Lakshan-D/spacecraft-buck-converter/results/loop_load_step_zoom.png

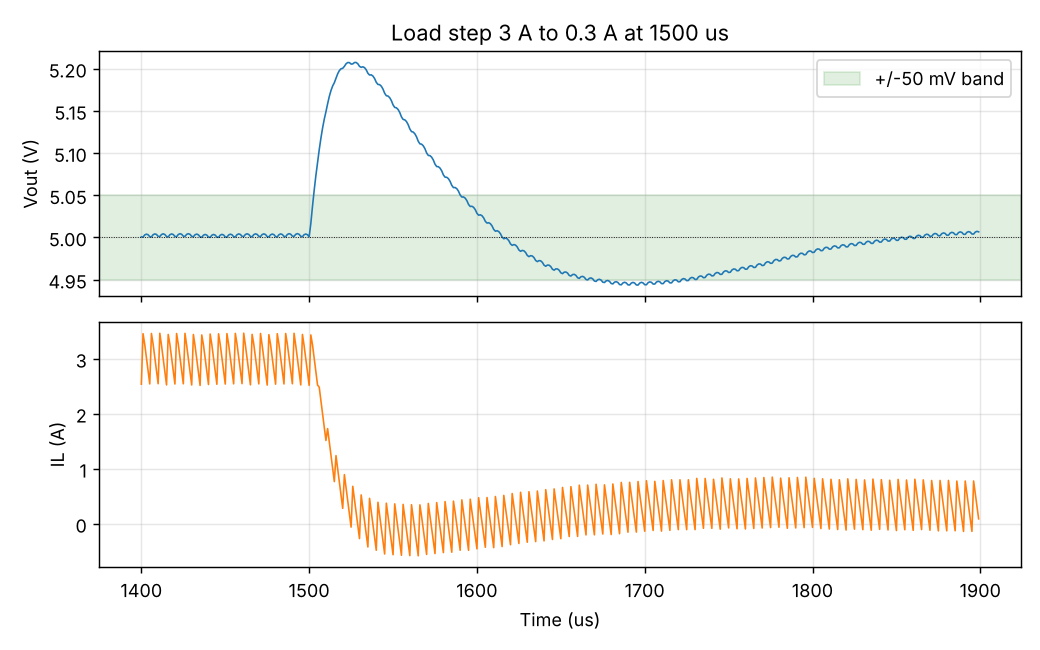
results/loop_load_step_zoom.png
