Lakshan-D/spacecraft-buck-converter/results/spice_load_step_open_loop.png

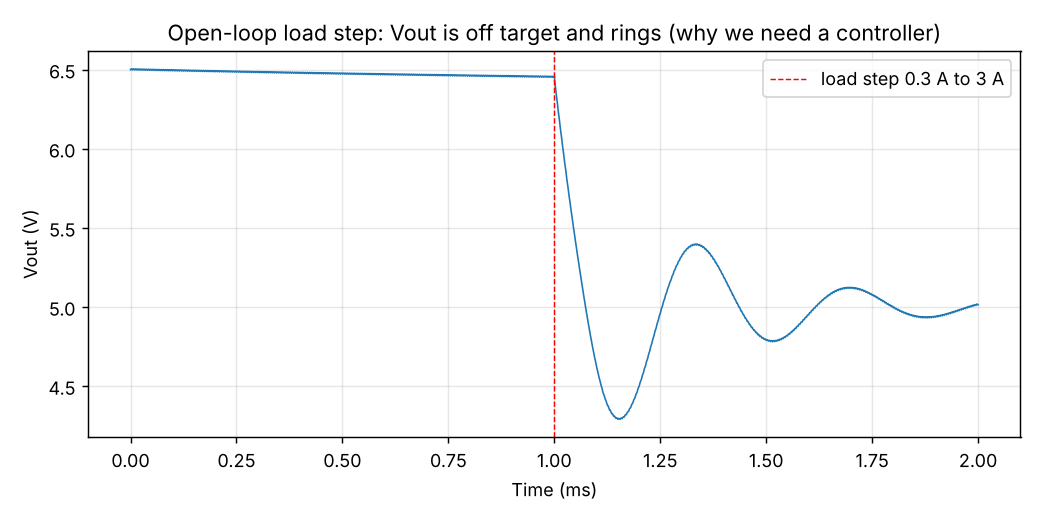
results/spice_load_step_open_loop.png
