Lakshan-D/spacecraft-buck-converter/results/ablation_summary.md

# Ablation: feedforward and soft start (auto-generated by scripts/ablation.py)

Peak deviation in mV / settling to +/-50 mV in us / peak inductor current in A.

| Event | Iteration 2 (neither) | Vin feedforward only | Soft start only | Feedforward + soft start |
|---|---|---|---|---|
| Start-up, 28 V, 3 A | 1079 / 552 / 10.3 | 1577 / 551 / 12.8 | 10 / 901 / 4.3 | 73 / 868 / 4.4 |
| Load 3 A to 0.3 A | 209 / 221 / 3.5 | 210 / 226 / 3.5 | 208 / 231 / 3.5 | 207 / 226 / 3.4 |
| Load 0.3 A to 3 A | 203 / 233 / 3.8 | 202 / 228 / 3.8 | 203 / 228 / 3.8 | 203 / 229 / 3.8 |
| Bus 28 V to 22 V | 232 / 226 / 3.5 | 30 / 0 / 3.3 | 234 / 226 / 3.5 | 31 / 0 / 3.3 |
| Bus 22 V to 36 V | 438 / 391 / 4.9 | 60 / 49 / 4.0 | 438 / 391 / 4.9 | 60 / 49 / 4.0 |
| Bus 36 V to 28 V | 193 / 215 / 3.6 | 24 / 0 / 3.5 | 194 / 216 / 3.6 | 23 / 0 / 3.5 |

## Bit-flip fault injection, same 200 upsets on both controllers

| Controller | Mode | Upsets > 100 mV | Upsets > 250 mV | Not recovered in 250 us | Worst peak (mV) | > 100 mV, clean starts only |
|---|---|---|---|---|---|---|
| Iteration 2 | no TMR | 57 / 200 | 43 / 200 | 35 / 200 | 2807 | 33 / 165 |
| Iteration 2 | TMR | 0 / 200 | 0 / 200 | 0 / 200 | 7 | 0 / 200 |
| Feedforward + soft start | no TMR | 69 / 200 | 54 / 200 | 44 / 200 | 5692 | 34 / 156 |
| Feedforward + soft start | TMR | 0 / 200 | 0 / 200 | 0 / 200 | 6 | 0 / 200 |
