Lakshan-D/spacecraft-buck-converter/results/loop_summary.md

# Closed-loop results (auto-generated by scripts/plot_results.py)

| Event | Peak deviation (mV) | Direction | Settling to +/-50 mV (us) | Peak IL (A) |
|---|---|---|---|---|
| Start-up, 28 V, 3 A | 73 | overshoot | 868 | 4.37 |
| Load 3 A to 0.3 A | 207 | overshoot | 226 | 3.43 |
| Load 0.3 A to 3 A | 203 | undershoot | 229 | 3.80 |
| Bus 28 V to 22 V | 31 | undershoot | 0 | 3.33 |
| Bus 22 V to 36 V | 60 | overshoot | 49 | 4.05 |
| Bus 36 V to 28 V | 23 | undershoot | 0 | 3.50 |

Steady state (28 V, 3 A): mean Vout = 5.0017 V, ripple = 7.1 mV pk-pk.
