Lakshan-D/spacecraft-buck-converter/results/spice_summary.md

# SPICE results (auto-generated by scripts/run_spice.py)

Nominal point (28 V in, 3 A out, typical parts): D = 0.19231, Vout = 5.000 V, ripple = 8.7 mV pk-pk, inductor ripple = 1.02 A pk-pk, efficiency = 91.8 %.

## Corner table (duty tuned per corner to hold 5.00 V)

| Vin (V) | Iout (A) | Parts | Duty | Vout (V) | Ripple (mV pk-pk) | IL pk (A) | Vsw max (V) | Eff (%) |
|---|---|---|---|---|---|---|---|---|
| 22 | 0.3 | cold | 0.19401 | 5.000 | 11.8 | 0.74 | 22.5 | 94.6 |
| 22 | 0.3 | typ | 0.19408 | 5.000 | 5.2 | 0.74 | 22.6 | 94.5 |
| 22 | 0.3 | hot | 0.19424 | 5.000 | 5.2 | 0.74 | 22.9 | 94.4 |
| 22 | 3.0 | cold | 0.24382 | 5.000 | 16.3 | 3.47 | 22.5 | 92.4 |
| 22 | 3.0 | typ | 0.24473 | 5.000 | 7.9 | 3.47 | 22.7 | 92.1 |
| 22 | 3.0 | hot | 0.24636 | 5.000 | 7.0 | 3.47 | 23.0 | 91.4 |
| 28 | 0.3 | cold | 0.14306 | 5.014 | 12.5 | 0.77 | 28.4 | 94.1 |
| 28 | 0.3 | typ | 0.14307 | 5.013 | 5.9 | 0.77 | 28.6 | 94.1 |
| 28 | 0.3 | hot | 0.14316 | 5.013 | 5.9 | 0.77 | 28.9 | 94.0 |
| 28 | 3.0 | cold | 0.19168 | 5.000 | 17.4 | 3.51 | 28.7 | 92.1 |
| 28 | 3.0 | typ | 0.19231 | 5.000 | 8.7 | 3.51 | 28.9 | 91.8 |
| 28 | 3.0 | hot | 0.19346 | 5.000 | 7.8 | 3.51 | 29.2 | 91.3 |
| 36 | 0.3 | cold | 0.10996 | 5.000 | 12.3 | 0.79 | 36.8 | 93.5 |
| 36 | 0.3 | typ | 0.11 | 5.000 | 5.6 | 0.79 | 37.1 | 93.5 |
| 36 | 0.3 | hot | 0.11008 | 5.000 | 5.7 | 0.79 | 37.6 | 93.4 |
| 36 | 3.0 | cold | 0.14898 | 5.000 | 18.1 | 3.53 | 36.7 | 91.9 |
| 36 | 3.0 | typ | 0.14942 | 5.000 | 9.3 | 3.53 | 37.0 | 91.6 |
| 36 | 3.0 | hot | 0.15022 | 5.000 | 8.4 | 3.53 | 37.5 | 91.1 |

## Open-loop line regulation (duty fixed at nominal)

| Vin (V) | Vout (V) |
|---|---|
| 22 | 3.870 |
| 28 | 5.000 |
| 36 | 6.509 |

Worst-case ripple 18.1 mV, worst-case inductor peak 3.53 A, worst-case switch node 37.6 V.

## Efficiency vs load (28 V in)

| Iout (A) | Eff (%) |
|---|---|
| 0.3 | 94.1 |
| 0.6 | 93.9 |
| 1.0 | 93.6 |
| 1.5 | 93.1 |
| 2.0 | 92.6 |
| 2.5 | 92.2 |
| 3.0 | 91.8 |
