Lakshan-D/spacecraft-buck-converter/results/fault_summary.md

# Fault injection results (auto-generated by scripts/plot_results.py)

Single bit flip in one state copy at a random time; Vout observed for 300 us.

| Metric | No TMR | TMR |
|---|---|---|
| Upsets injected | 200 | 200 |
| Upsets with peak error > 100 mV (2 %) | 69 | 0 |
| Upsets with peak error > 250 mV (5 %) | 54 | 0 |
| Not recovered to +/-50 mV within 250 us | 44 | 0 |
| Worst peak error (mV) | 5692 | 6 |
| Median peak error (mV) | 48 | 5 |

## Breakdown by register (no TMR)

| Register | Bits | Upsets | Caused > 100 mV |
|---|---|---|---|
| duty | 10 | 29 | 8 |
| e_prev | 16 | 46 | 12 |
| integrator | 32 | 91 | 37 |
| soft start ref | 12 | 34 | 12 |

With TMR, the voter output masks the flipped copy; the mismatch flag is raised in 200/200 cases (telemetry for ground).
