Lakshan-D/spacecraft-buck-converter/results/ablation_ff.csv

t_us | vo | il | duty | vin | rload
0.005 | 0.00000 | 0.00000 | x | 28.0 | 1.667
1.005 | 0.00000 | 0.00000 | 0 | 28.0 | 1.667
2.005 | 0.00000 | 0.00000 | 0 | 28.0 | 1.667
3.005 | 0.00000 | 0.00000 | 0 | 28.0 | 1.667
4.005 | 0.00000 | 0.00000 | 0 | 28.0 | 1.667
5.005 | 0.00000 | 0.00000 | 0 | 28.0 | 1.667
6.005 | 0.00354 | 1.15577 | 400 | 28.0 | 1.667
7.005 | 0.01547 | 2.42000 | 400 | 28.0 | 1.667
8.005 | 0.03574 | 3.67776 | 400 | 28.0 | 1.667
9.005 | 0.06428 | 4.92872 | 400 | 28.0 | 1.667
10.005 | 0.09746 | 5.01676 | 400 | 28.0 | 1.667
11.005 | 0.13390 | 6.14461 | 298 | 28.0 | 1.667
12.005 | 0.17841 | 7.37957 | 298 | 28.0 | 1.667
13.005 | 0.23092 | 8.60673 | 298 | 28.0 | 1.667
14.005 | 0.28767 | 8.64465 | 298 | 28.0 | 1.667
15.005 | 0.34386 | 8.59113 | 298 | 28.0 | 1.667
16.005 | 0.40301 | 9.69109 | 181 | 28.0 | 1.667
17.005 | 0.46989 | 10.77001 | 181 | 28.0 | 1.667
18.005 | 0.53943 | 10.69829 | 181 | 28.0 | 1.667
19.005 | 0.60821 | 10.62376 | 181 | 28.0 | 1.667
20.005 | 0.67621 | 10.54646 | 181 | 28.0 | 1.667
21.005 | 0.74696 | 11.62222 | 115 | 28.0 | 1.667
22.005 | 0.82281 | 11.83817 | 115 | 28.0 | 1.667
23.005 | 0.89798 | 11.74547 | 115 | 28.0 | 1.667
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
