Lakshan-D/spacecraft-buck-converter/results/ablation_ss.csv

t_us | vo | il | duty | vin | rload
0.005 | 0.00000 | 0.00000 | x | 28.0 | 1.667
1.005 | 0.00000 | 0.00000 | 0 | 28.0 | 1.667
2.005 | 0.00000 | 0.00000 | 0 | 28.0 | 1.667
3.005 | 0.00000 | 0.00000 | 0 | 28.0 | 1.667
4.005 | 0.00000 | 0.00000 | 0 | 28.0 | 1.667
5.005 | 0.00000 | 0.00000 | 0 | 28.0 | 1.667
6.005 | 0.00178 | 0.34240 | 27 | 28.0 | 1.667
7.005 | 0.00405 | 0.34072 | 27 | 28.0 | 1.667
8.005 | 0.00629 | 0.33894 | 27 | 28.0 | 1.667
9.005 | 0.00852 | 0.33707 | 27 | 28.0 | 1.667
10.005 | 0.01072 | 0.33510 | 27 | 28.0 | 1.667
11.005 | 0.01415 | 0.56127 | 18 | 28.0 | 1.667
12.005 | 0.01782 | 0.55800 | 18 | 28.0 | 1.667
13.005 | 0.02145 | 0.55458 | 18 | 28.0 | 1.667
14.005 | 0.02504 | 0.55101 | 18 | 28.0 | 1.667
15.005 | 0.02860 | 0.54730 | 18 | 28.0 | 1.667
16.005 | 0.03318 | 0.73361 | 15 | 28.0 | 1.667
17.005 | 0.03791 | 0.72867 | 15 | 28.0 | 1.667
18.005 | 0.04259 | 0.72354 | 15 | 28.0 | 1.667
19.005 | 0.04721 | 0.71822 | 15 | 28.0 | 1.667
20.005 | 0.05179 | 0.71272 | 15 | 28.0 | 1.667
21.005 | 0.05703 | 0.83380 | 10 | 28.0 | 1.667
22.005 | 0.06233 | 0.82732 | 10 | 28.0 | 1.667
23.005 | 0.06756 | 0.82062 | 10 | 28.0 | 1.667
24.005 | 0.07273 | 0.81372 | 10 | 28.0 | 1.667
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
