Lakshan-D/spacecraft-buck-converter/results/fault_base_tmr0.csv

idx | copy | bit | peak_mV | tail_mV | detected
0 | 0 | 53 | 2806.3 | 225.2 | 1
1 | 0 | 48 | 345.8 | 84.8 | 1
2 | 0 | 51 | 2807.0 | 266.7 | 1
3 | 0 | 7 | 291.7 | 34.2 | 1
4 | 0 | 62 | 38.3 | 7.1 | 1
5 | 0 | 43 | 21.5 | 4.7 | 1
6 | 0 | 65 | 8.4 | 4.6 | 1
7 | 0 | 45 | 76.2 | 8.4 | 1
8 | 0 | 0 | 12.5 | 2.6 | 1
9 | 0 | 40 | 6.6 | 4.4 | 1
10 | 0 | 47 | 294.4 | 29.3 | 1
11 | 0 | 68 | 37.8 | 7.5 | 1
12 | 0 | 25 | 78.0 | 23.3 | 1
13 | 0 | 60 | 10.8 | 4.4 | 1
14 | 0 | 69 | 4.6 | 2.6 | 1
15 | 0 | 33 | 6.5 | 4.6 | 1
16 | 0 | 58 | 4.5 | 2.9 | 1
17 | 0 | 2 | 5.0 | 4.5 | 1
18 | 0 | 20 | 85.2 | 22.9 | 1
19 | 0 | 54 | 2806.0 | 257.7 | 1
20 | 0 | 66 | 348.1 | 46.6 | 1
21 | 0 | 63 | 46.0 | 5.6 | 1
22 | 0 | 37 | 4.5 | 2.5 | 1
23 | 0 | 48 | 585.5 | 50.8 | 1
24 | 0 | 10 | 77.2 | 11.0 | 1
25 | 0 | 41 | 10.6 | 4.3 | 1
26 | 0 | 19 | 83.5 | 23.2 | 1
27 | 0 | 6 | 10.7 | 4.6 | 1
28 | 0 | 36 | 4.7 | 4.4 | 1
29 | 0 | 69 | 4.6 | 3.7 | 1
30 | 0 | 7 | 106.4 | 24.4 | 1
31 | 0 | 56 | 2805.2 | 232.3 | 1
32 | 0 | 25 | 280.0 | 37.3 | 1
33 | 0 | 17 | 206.8 | 47.1 | 1
34 | 0 | 67 | 18.0 | 6.3 | 1
35 | 0 | 24 | 265.9 | 67.6 | 1
36 | 0 | 8 | 29.2 | 6.4 | 1
37 | 0 | 6 | 5.6 | 4.5 | 1
38 | 0 | 20 | 85.2 | 23.6 | 1
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
