Lakshan-D/spacecraft-buck-converter/results/fault_base_tmr1.csv

idx | copy | bit | peak_mV | tail_mV | detected
0 | 1 | 53 | 4.5 | 4.5 | 1
1 | 1 | 3 | 4.9 | 4.4 | 1
2 | 1 | 7 | 4.9 | 4.6 | 1
3 | 0 | 60 | 4.7 | 3.5 | 1
4 | 1 | 65 | 4.6 | 2.8 | 1
5 | 2 | 64 | 4.8 | 4.0 | 1
6 | 1 | 40 | 4.7 | 4.4 | 1
7 | 1 | 58 | 5.1 | 2.7 | 1
8 | 2 | 25 | 6.7 | 6.7 | 1
9 | 1 | 17 | 6.2 | 2.8 | 1
10 | 2 | 33 | 5.1 | 4.4 | 1
11 | 1 | 47 | 4.5 | 2.6 | 1
12 | 2 | 20 | 6.7 | 4.6 | 1
13 | 2 | 56 | 5.0 | 2.8 | 1
14 | 1 | 63 | 5.1 | 2.5 | 1
15 | 2 | 63 | 6.7 | 6.2 | 1
16 | 0 | 10 | 5.0 | 4.4 | 1
17 | 1 | 50 | 5.1 | 3.4 | 1
18 | 0 | 6 | 6.0 | 6.0 | 1
19 | 2 | 14 | 6.7 | 3.8 | 1
20 | 1 | 7 | 5.1 | 4.4 | 1
21 | 2 | 60 | 4.5 | 2.6 | 1
22 | 2 | 17 | 6.7 | 4.6 | 1
23 | 2 | 42 | 5.0 | 2.8 | 1
24 | 0 | 8 | 5.1 | 2.6 | 1
25 | 2 | 21 | 6.7 | 6.2 | 1
26 | 1 | 65 | 5.0 | 4.8 | 1
27 | 1 | 35 | 5.1 | 4.0 | 1
28 | 0 | 42 | 5.2 | 5.2 | 1
29 | 0 | 2 | 6.7 | 4.3 | 1
30 | 2 | 20 | 5.1 | 5.1 | 1
31 | 1 | 47 | 4.5 | 2.6 | 1
32 | 2 | 16 | 6.7 | 4.6 | 1
33 | 1 | 32 | 5.0 | 3.9 | 1
34 | 0 | 68 | 5.1 | 2.6 | 1
35 | 2 | 26 | 6.7 | 6.2 | 1
36 | 0 | 26 | 5.0 | 5.0 | 1
37 | 0 | 68 | 5.1 | 4.5 | 1
38 | 1 | 30 | 4.4 | 4.4 | 1
39 | 2 | 37 | 6.7 | 4.3 | 1
40 | 2 | 17 | 5.1 | 5.1 | 1
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
