Lakshan-D/spacecraft-buck-converter/results/fault_tmr0.csv

idx | copy | bit | peak_mV | tail_mV | detected
0 | 0 | 53 | 5576.1 | 301.2 | 1
1 | 0 | 48 | 904.0 | 90.3 | 1
2 | 0 | 51 | 5541.0 | 328.6 | 1
3 | 0 | 7 | 318.7 | 37.6 | 1
4 | 0 | 62 | 43.8 | 6.5 | 1
5 | 0 | 43 | 19.6 | 3.4 | 1
6 | 0 | 65 | 8.6 | 4.6 | 1
7 | 0 | 45 | 75.7 | 9.4 | 1
8 | 0 | 0 | 10.6 | 4.4 | 1
9 | 0 | 40 | 4.6 | 4.6 | 1
10 | 0 | 47 | 296.7 | 27.7 | 1
11 | 0 | 68 | 38.6 | 6.9 | 1
12 | 0 | 25 | 79.8 | 22.8 | 1
13 | 0 | 60 | 9.3 | 2.4 | 1
14 | 0 | 69 | 4507.1 | 3343.4 | 1
15 | 0 | 33 | 2391.3 | 482.5 | 1
16 | 0 | 58 | 180.8 | 13.5 | 1
17 | 0 | 2 | 8.7 | 6.5 | 1
18 | 0 | 20 | 264.0 | 67.6 | 1
19 | 0 | 54 | 5589.9 | 338.7 | 1
20 | 0 | 66 | 366.9 | 48.1 | 1
21 | 0 | 63 | 47.7 | 6.6 | 1
22 | 0 | 37 | 4.7 | 4.4 | 1
23 | 0 | 48 | 588.4 | 55.4 | 1
24 | 0 | 10 | 72.5 | 10.5 | 1
25 | 0 | 41 | 10.6 | 4.3 | 1
26 | 0 | 19 | 87.0 | 25.4 | 1
27 | 0 | 6 | 11.8 | 4.4 | 1
28 | 0 | 36 | 6.9 | 4.8 | 1
29 | 0 | 69 | 4508.6 | 3298.3 | 1
30 | 0 | 7 | 2326.4 | 478.3 | 1
31 | 0 | 56 | 5692.3 | 287.8 | 1
32 | 0 | 25 | 281.5 | 40.1 | 1
33 | 0 | 17 | 208.7 | 46.6 | 1
34 | 0 | 67 | 507.0 | 121.4 | 1
35 | 0 | 24 | 107.1 | 30.7 | 1
36 | 0 | 8 | 10.6 | 4.6 | 1
37 | 0 | 6 | 4.8 | 4.4 | 1
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
