Lakshan-D/spacecraft-buck-converter/results/fault_tmr1.csv

idx | copy | bit | peak_mV | tail_mV | detected
0 | 1 | 53 | 4.9 | 4.4 | 1
1 | 1 | 3 | 4.7 | 4.7 | 1
2 | 1 | 7 | 5.1 | 4.6 | 1
3 | 0 | 60 | 4.8 | 4.4 | 1
4 | 1 | 65 | 2.6 | 2.6 | 1
5 | 2 | 64 | 6.5 | 4.5 | 1
6 | 1 | 40 | 5.0 | 4.4 | 1
7 | 1 | 58 | 4.9 | 4.3 | 1
8 | 2 | 25 | 4.7 | 4.6 | 1
9 | 1 | 17 | 4.8 | 4.6 | 1
10 | 2 | 33 | 5.0 | 2.6 | 1
11 | 1 | 47 | 5.1 | 5.0 | 1
12 | 2 | 20 | 4.8 | 4.8 | 1
13 | 2 | 56 | 4.5 | 2.5 | 1
14 | 1 | 63 | 6.5 | 6.5 | 1
15 | 2 | 63 | 6.5 | 5.0 | 1
16 | 0 | 10 | 4.5 | 4.5 | 1
17 | 1 | 50 | 4.9 | 4.7 | 1
18 | 0 | 6 | 4.8 | 4.8 | 1
19 | 2 | 14 | 4.6 | 4.6 | 1
20 | 1 | 7 | 5.1 | 4.5 | 1
21 | 2 | 60 | 5.0 | 4.4 | 1
22 | 2 | 17 | 4.8 | 4.5 | 1
23 | 2 | 42 | 4.5 | 2.5 | 1
24 | 0 | 8 | 6.5 | 4.5 | 1
25 | 2 | 21 | 5.0 | 3.6 | 1
26 | 1 | 65 | 4.9 | 4.5 | 1
27 | 1 | 35 | 4.7 | 4.4 | 1
28 | 0 | 42 | 4.8 | 4.4 | 1
29 | 0 | 2 | 5.0 | 4.1 | 1
30 | 2 | 20 | 5.1 | 3.2 | 1
31 | 1 | 47 | 5.0 | 4.8 | 1
32 | 2 | 16 | 4.7 | 2.3 | 1
33 | 1 | 32 | 6.5 | 6.5 | 1
34 | 0 | 68 | 6.5 | 3.2 | 1
35 | 2 | 26 | 5.0 | 4.4 | 1
36 | 0 | 26 | 4.9 | 3.6 | 1
37 | 0 | 68 | 4.7 | 3.9 | 1
38 | 1 | 30 | 4.8 | 4.2 | 1
39 | 2 | 37 | 5.1 | 5.1 | 1
40 | 2 | 17 | 5.0 | 4.4 | 1
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
