Lakshan-D/spacecraft-buck-converter/results/spice_efficiency.png

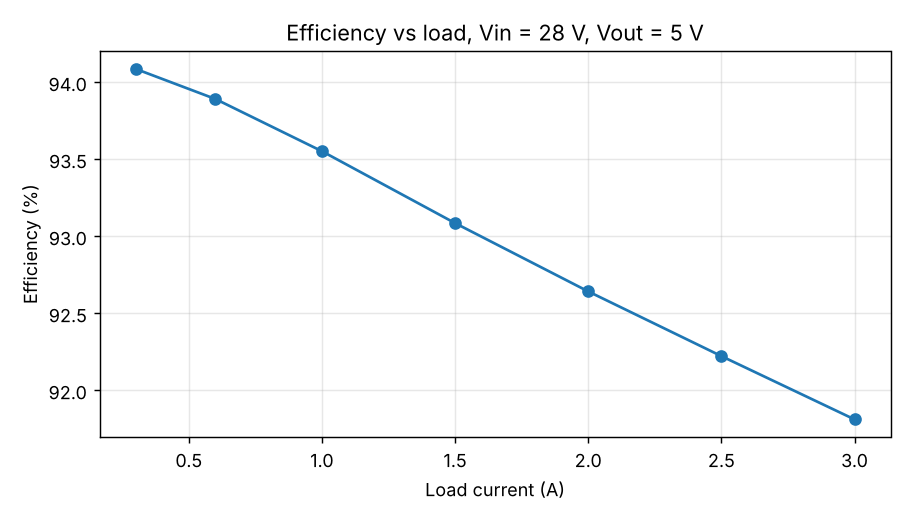
results/spice_efficiency.png
