Lakshan-D/spacecraft-buck-converter/results/spice_steady_state.png

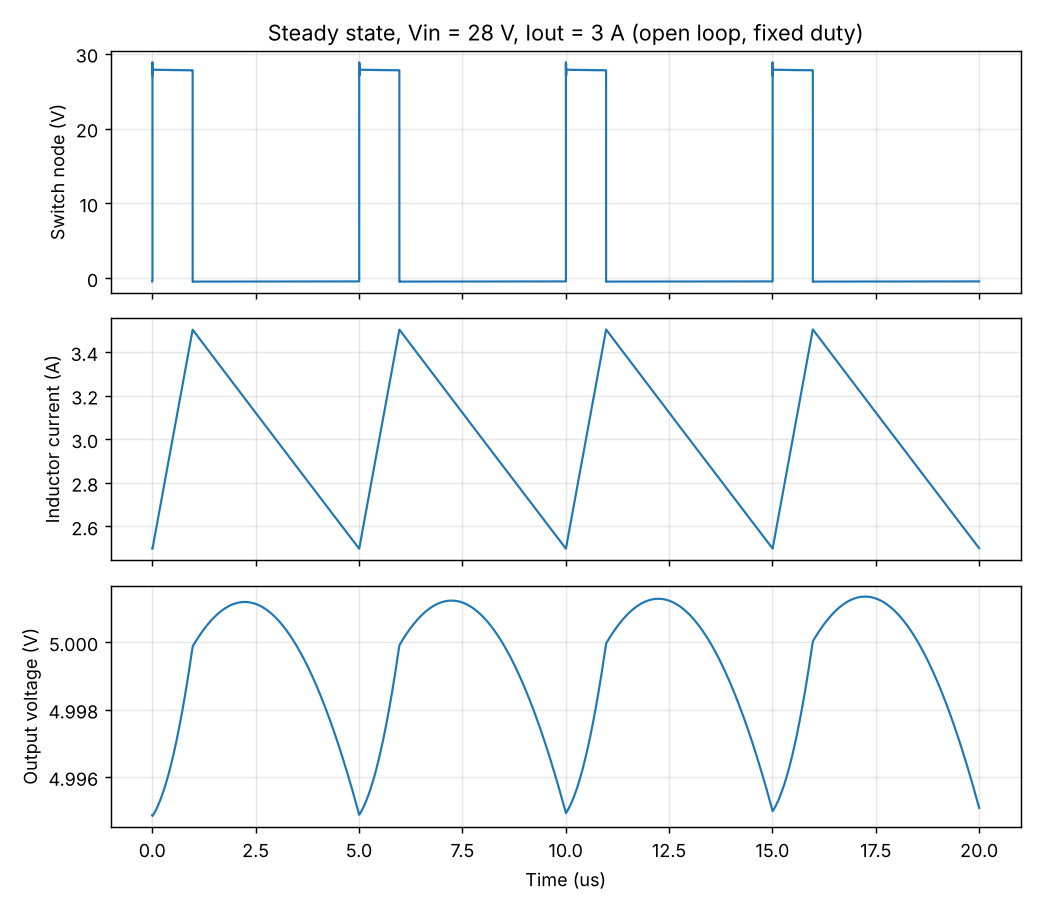
results/spice_steady_state.png
