Lakshan-D/spacecraft-buck-converter/(commit log)

2026-10-01 Add files via upload
    Add 28 V buck converter simulation: SPICE, Verilog PID, TMR fault injection
    [fault_tmr0.csv, fault_tmr1.csv, golden_log.csv, loop_log.csv, spice_corners.csv]
2026-10-08 Iteration 2: 150 uF output capacitor, retuned PID
